wheeler-microfluidics/PMT-transimpedance-amplifier/(threads)

Thread 1 (2017-06-07):

Identify a better ADC

ryanfobel, 2017-06-07:
## Requirements
* SPI
* works with 3.3V logic
* differential mode
* \>=16 bits
* not too small/easy to solder (no BGA/QFN)

AlexSklav, 2017-08-18:
MAX11210
24-Bit, Single-Channel, Ultra-Low-Power, Delta-Sigma ADC

Closed 2017-08-18.
