wheeler-microfluidics/PMT-transimpedance-amplifier/(commit log)

2017-06-05 Initial revision
    [pmt-transimpedance-amplifier.kicad_pcb, pmt-transimpedance-amplifier.sch]
2017-06-05 IVC R set to 30kΩ IVC C set to 200pF Added Buffer Circuit, PMT Control Voltage and Power for the VUSB of the Teensy 3.2
    [pmt-transimpedance-amplifier.sch]
2017-06-06 Separate connectors for 5V, GND & VControl
    [pmt-transimpedance-amplifier.sch]
2017-06-07 Removed the Buffer from the GND and connected the the IVC to the A10 and A11 pins of the Teensy for 16 bit resolution
    [pmt-transimpedance-amplifier.sch]
2017-06-07 Add ADC, PMT mount, wire schematic
    [pmt-transimpedance-amplifier.kicad_pcb, pmt-transimpedance-amplifier.sch]
